evandrosouza-developer/Tester-ps2-msx/Documentation/Tester Technical and Performance Manual.pdf

# Technical and Performance Manual

### Tester for PS/2 to MSX Keyboard adapter

## Introduction

This document aims to report applicable tests capability of the equipment developed to simulate the MSX keyboard subsystem.

## Technical foundation

### How MSX reads the keyboard

The MSX standard says that to read a key from the keyboard, you have to choose a column (Y_SCAN) through PC3:0 [IO port 0xAA – The BCD decoder (CI-16 7445 in HB-8000 and the equivalent chip inside the keyboard on XP-800) will put a low level onto the selected Y line] and read 8 bits of the other side of the matrix through PB7:0 without any extra delays. Here is two MSX example schematics to illustrate how to:

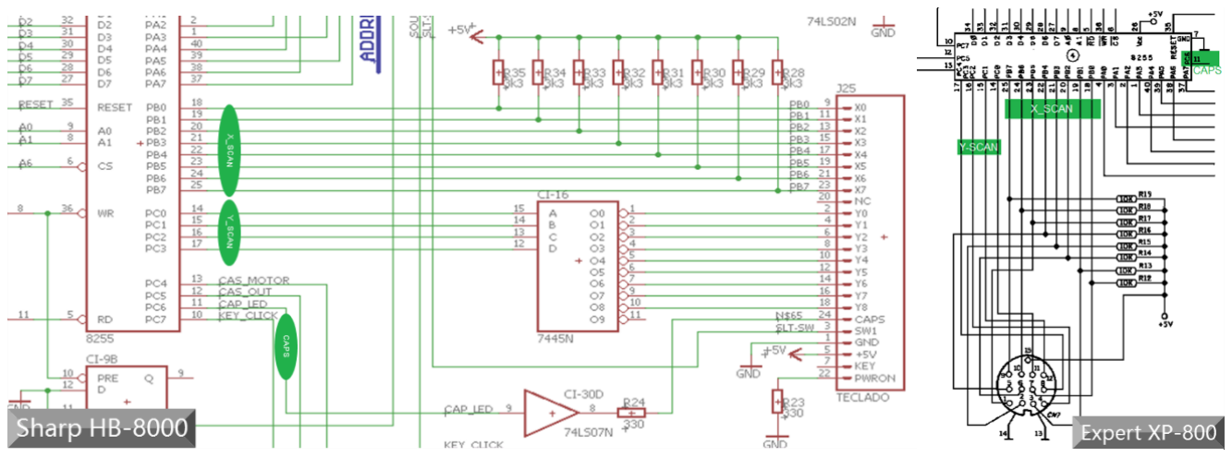
[picture p1: figure]

The detailed Z80 timing of a real MSX is represented here:

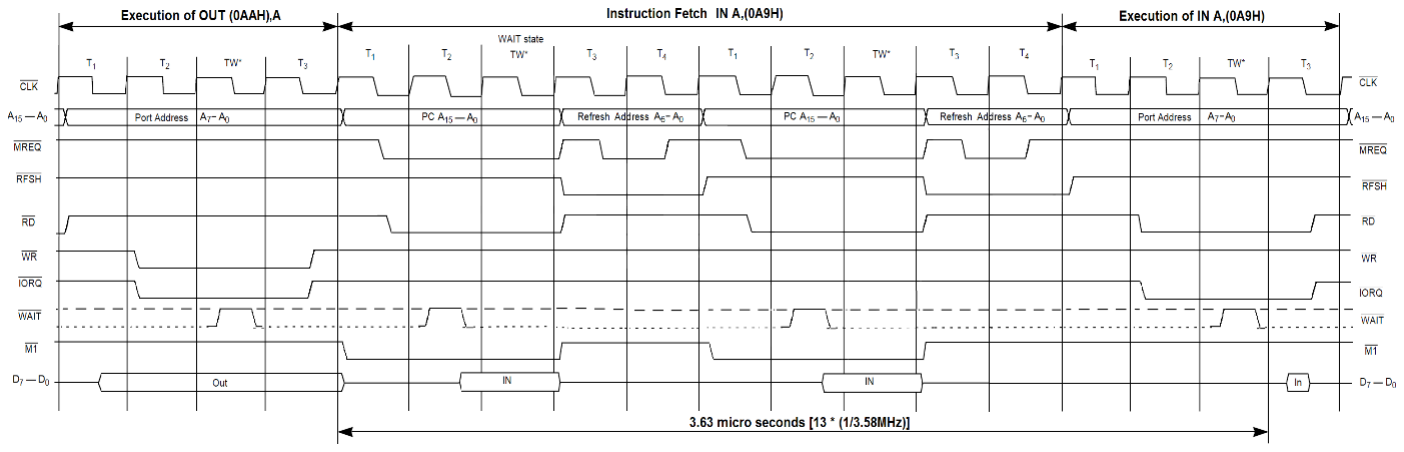
[picture p2: figure]

We have a window of about 3.65µs between the data is available from OUT (0xAA), A until the data sampling of the IN A, (0xA9) command.

So, to make a useful develop tool MSX keyboard subsystem simulator, I need to add the following configurable parameters:

1) Scan frequency: Number of “out’s” per second;
2) Delay to read the window time between the out and the sampled data (our 3.63µs);
3) Control the start and end colunms of the sweep;
4) Pause, single sweep and step-by-step run;
5) Control of the state of Caps Lock and Kana Lock: Blink, on and off states independently configurable.

The terminal configuration screen is:

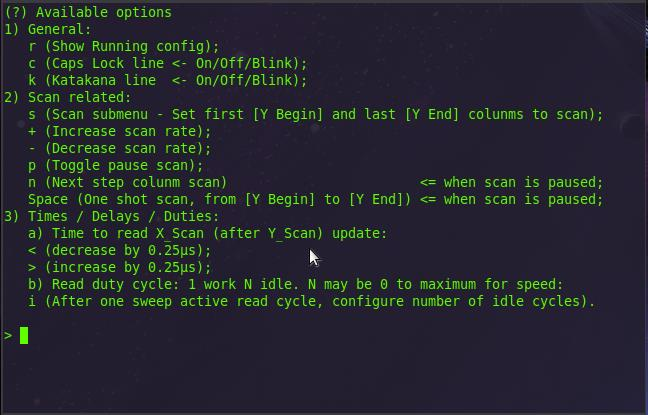
[picture p3: figure]

Timing definitions and controls used in this design:

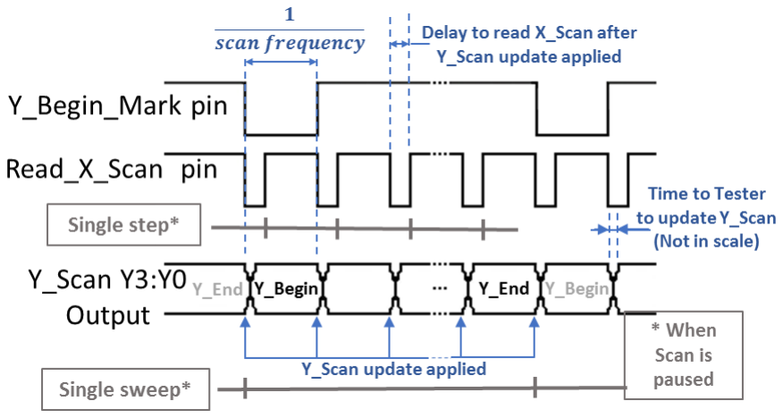
[picture p4: figure]

## The electronics

The electronics is quite simple => Only need a low cost Blue Pill (STM32F103C6T6 or greater) or Black Pill (STM32F401CCU6 or greater), with no PCB at all:

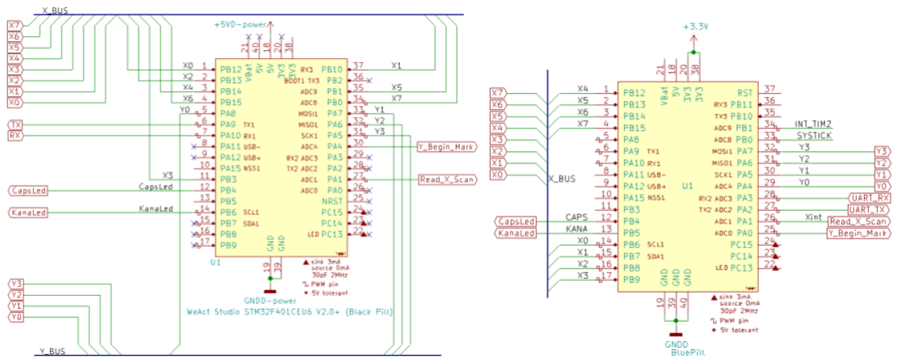
[picture p5: figure]

The choice of this was based on the pre-requisites:

1) Easy to get (High availability and low cost);
2) Use of the same platform of STM32F1 and STM32F4 based PS/2 to MSX Keyboard adapter (Hardware and Software develop tools), to minimize time to go, as learning time is mitigated;
3) Capability to use the same basic Firmware Structure: only develop complementary functions;

Real examples of working.

## 1) MSX Gradiente Expert XP-800 application:

Column scan frequency: 120KHz;

Y_Begin: 0;

Y_End: 9

Here is the keyboard map:

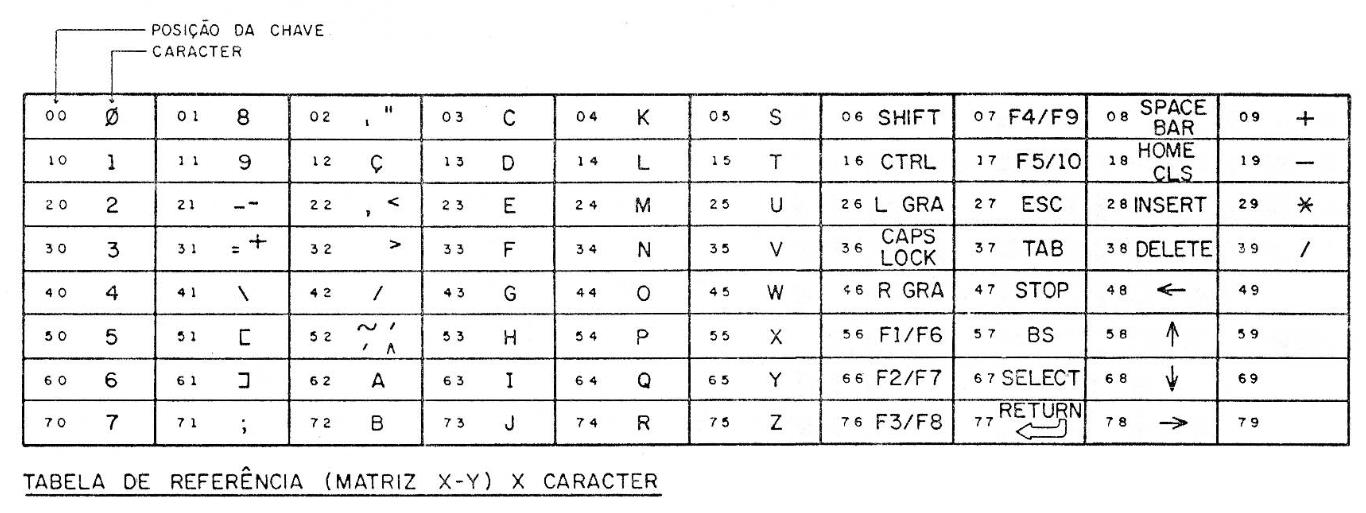
[picture p6: figure]

The yellow line (channel 1) marks Y_Begin (freq=120K/10 [0 to 9]) and blue line marks each column (120KHz). The start of data begins at falling transition (valid on both situations):

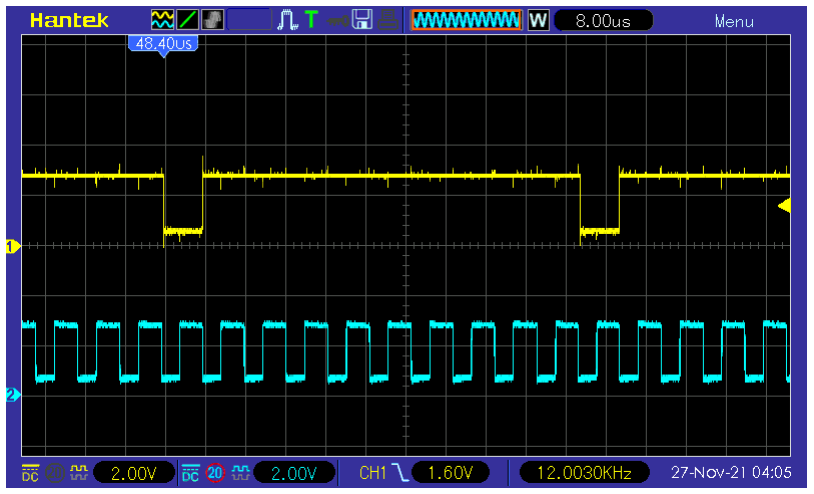
[picture p7: figure]

2) Sharp/Epcom Hotbit HB-8000 application:

Column scan frequency: 120KHz;

Y_Begin: 0;

Y_End: 8

The keyboard map – Here the yellow mapping are the keys who shift function differs from PS/2:

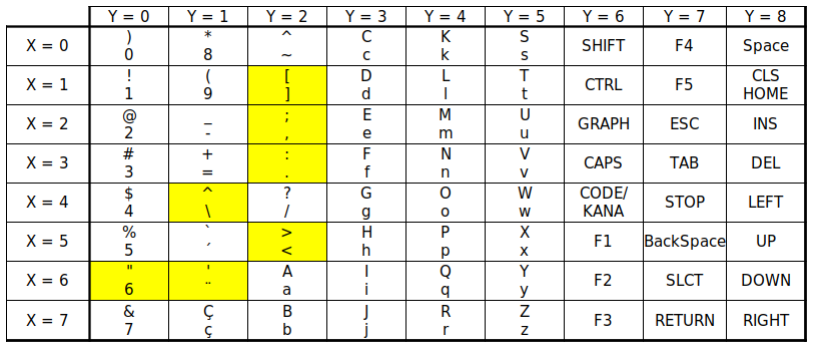
[picture p8: figure]

Now the yellow line shows 13.33KHz, because we are scanning 9 columns [0 to 8], instead of 10 [0 to 9] as used in XP-800:

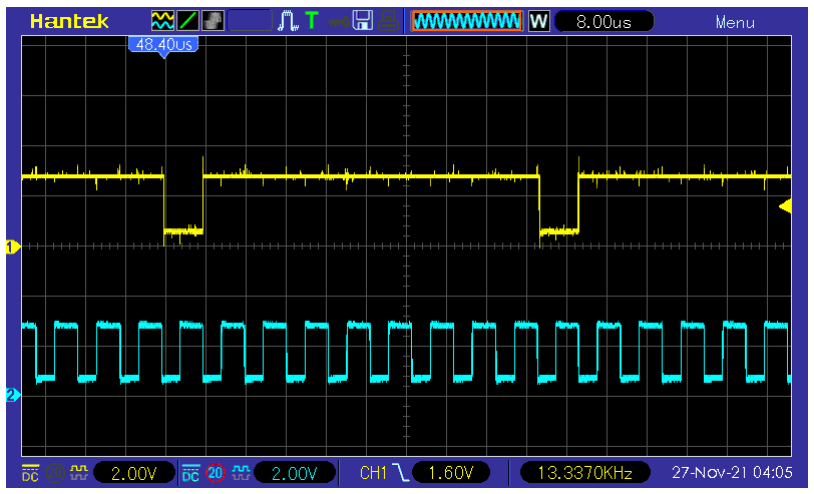
[picture p9: figure]

Here are the benchmarks of setting reading window.

IMPORTANT: Scan frequency and delay to read timing are referred to each colunm, not the all the keyboard.

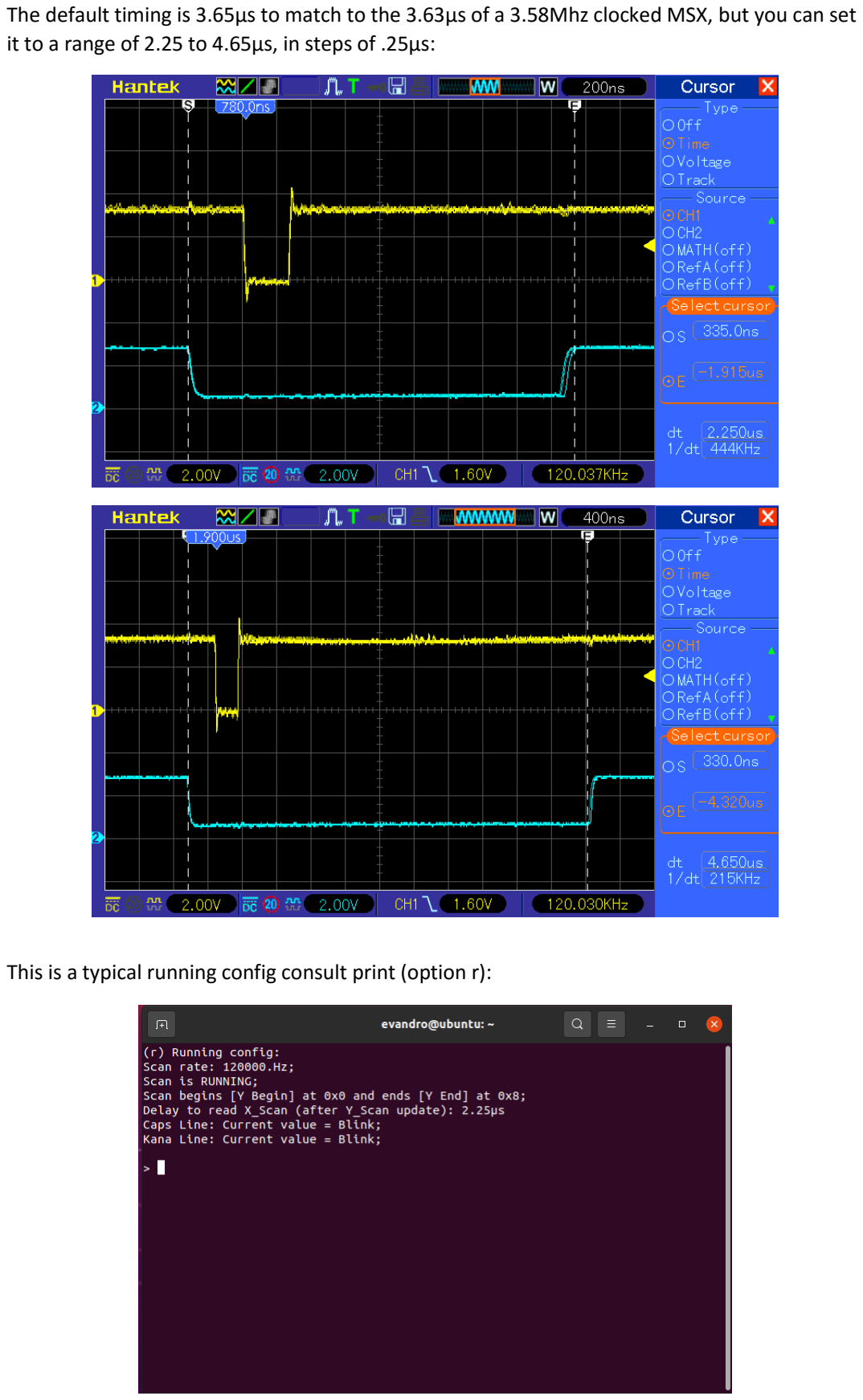
[picture p10: page 6]

The default timing is 3.65µs to match to the 3.63µs of a 3.58Mhz clocked MSX, but you can set it to a range of 2.25 to 4.65µs, in steps of .25µs:

This is a typical running config consult print (option r):

## How to use this tool to measure the performance of the PS/2 to MSX Keyboard adapter:

1) To measure the delay to the Adapter answer the request, here an example:

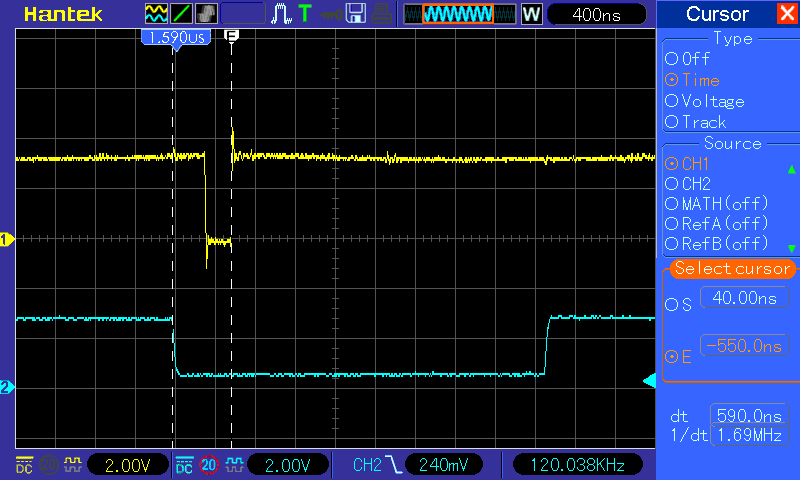
[picture p11: figure]

In this example, we can see the total performance of a response from the point the Tester put data (Pin S, at port A1 of Tester) to the point the routine ended processing (Pin E, on the PS2-MSXF4 Adapter’s port B7).

Other data could be how much time it spends “on processing”:

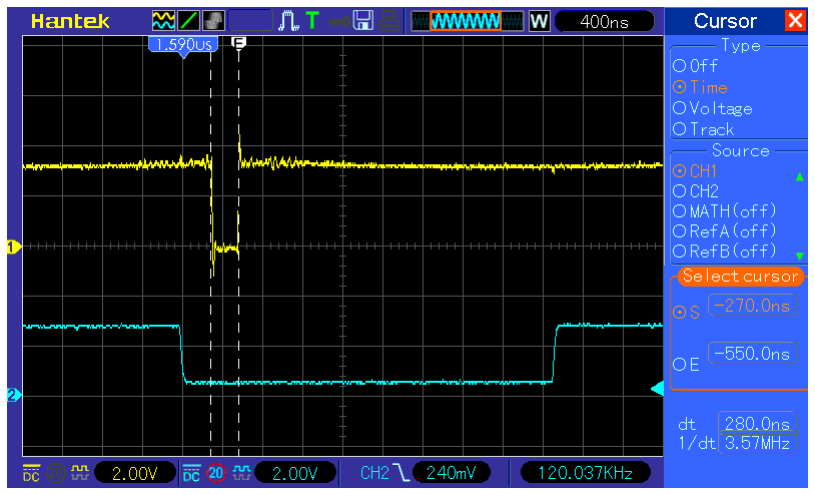
[picture p12: figure]

To get referenced, the blue trace window is a 3.65µs wide:

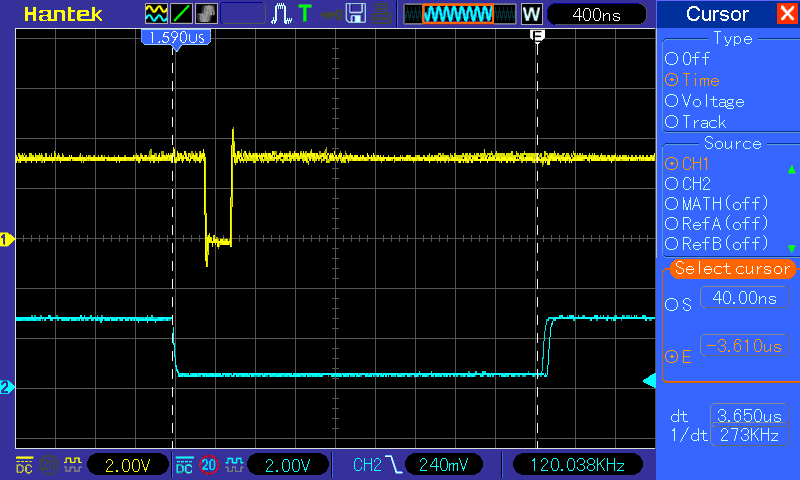
[picture p13: figure]
