evandrosouza-developer/Tester-ps2-msx/Documentation/tester-ps2-msxF1 Schematics.pdf

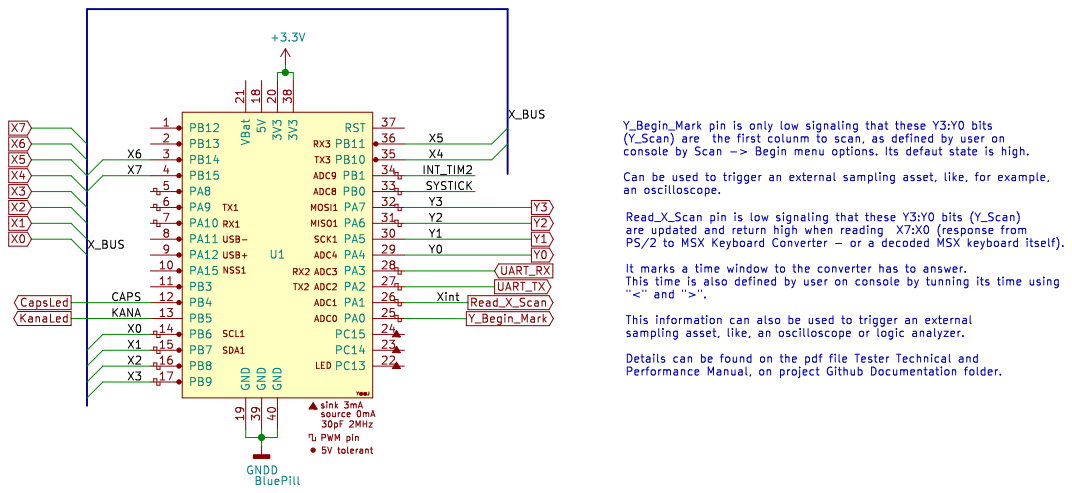
[picture p20: page 1]
