evandrosouza-developer/Tester-ps2-msx/Documentation/tester-ps2-msxF4 Schematics.pdf

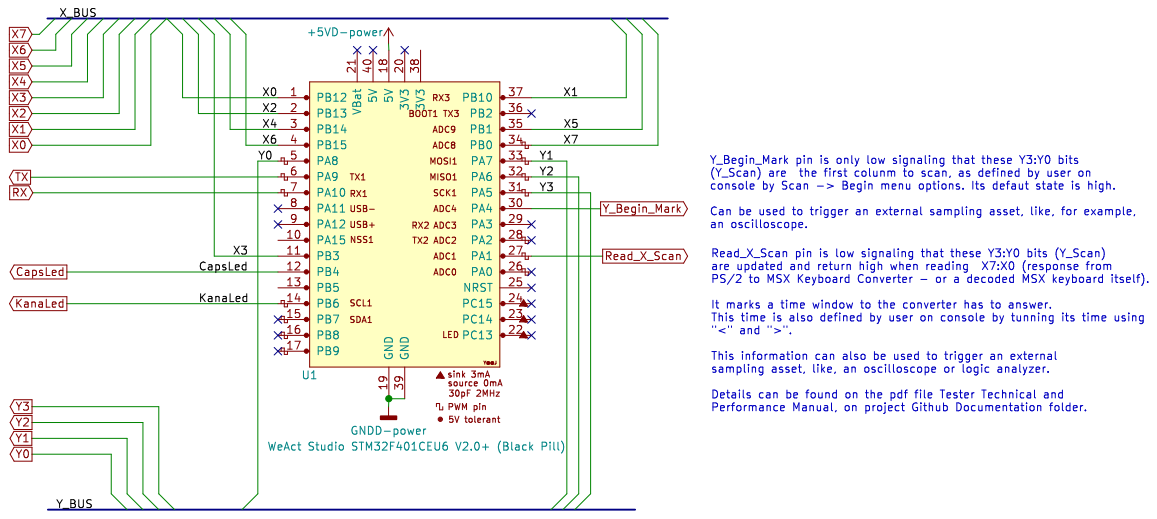
[picture p21: page 1]
