evandrosouza-developer/Tester-ps2-msx/Documentation/Kicad/F1/Tester F1 Schematic.pdf

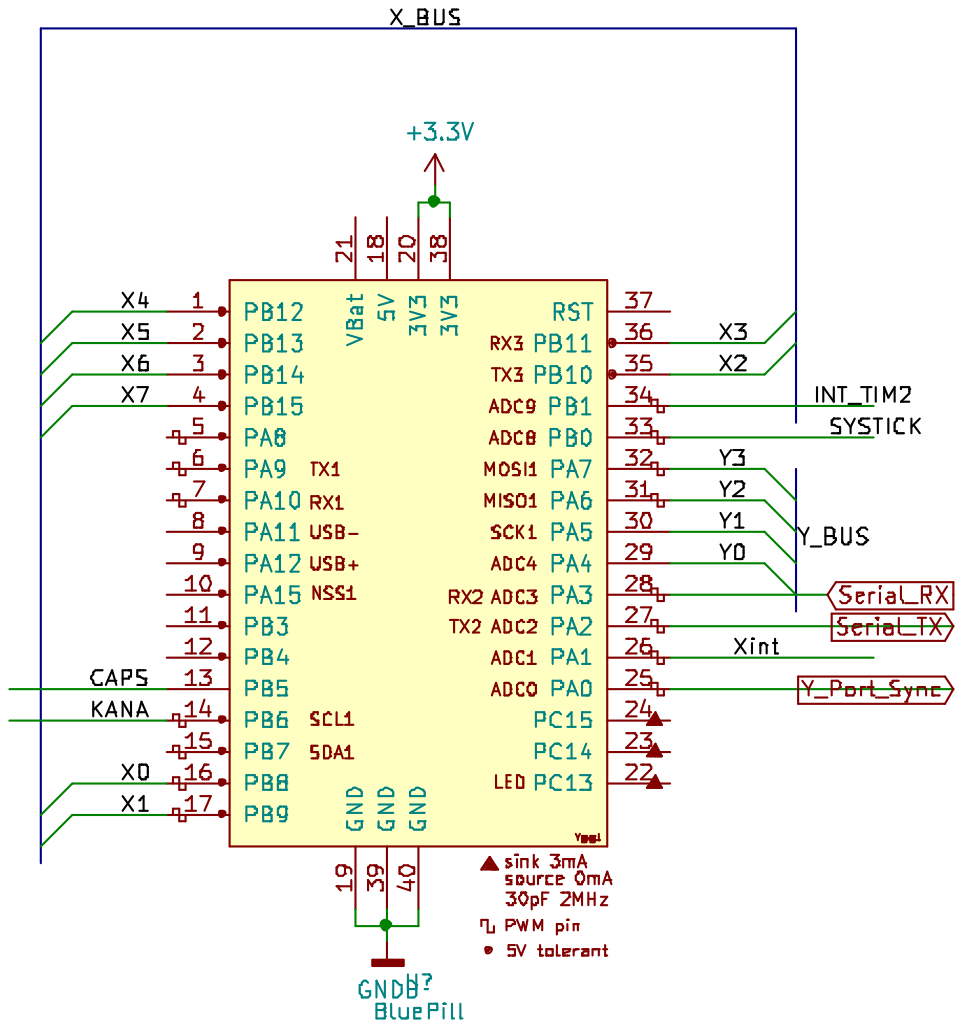
[picture p22: page 1]
