evandrosouza-developer/Tester-ps2-msx/t_msxmap.cpp

/** @addtogroup 07 msxmap t_msxmap_misc_group
 *
 * @ingroup infrastructure_apis
 *
 * @file t_msxmap.cpp General port initializations, complementary string function and mounts data of MSX adapter changes
 *
 * @brief <b>General port initializations, complementary string function and mounts data of MSX adapter changes</b>
 *
 * @version 1.0.0
 *
 * @author @htmlonly &copy; @endhtmlonly 2022
 * Evandro Souza <evandro.r.souza@gmail.com>
 *
 * @date 01 September 2022
 *
 * This library supports the setup pin ports and process the read data from 
 * PS/2 to MSX Keyboard Converter to be presented at the main menu loop,
 * to both the STM32F4 and STM32F1 series of ARM Cortex Microcontrollers
 * by ST Microelectronics.
 *
 * LGPL License Terms ref lgpl_license
 */
/*
 * This file is part of the MSX Keyboard Subsystem Emulator project.
 *
 * Copyright (C) 2022 Evandro Souza <evandro.r.souza@gmail.com>
 *
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
 * You should have received a copy of the GNU Lesser General Public License
 * along with this library.  If not, see <http://www.gnu.org/licenses/>.
 */

//Use Tab width=2

#include <libopencm3/cm3/systick.h>
#include <libopencm3/stm32/rcc.h>

#include "t_msxmap.h"

//Variáveis globais: Visíveis por todo o contexto do programa
extern uint32_t systicks;                           //Declared on sys_timer.cpp
extern uint8_t scancount_init, scancount_end;       //Declared on sys_timer.cpp
extern uint8_t y_scan;                              //Declared on sys_timer.cpp
extern bool wait_flag, single_step, single_sweep;   //Declared on sys_timer.cpp
extern uint8_t inactivity_cycles[SCAN_POINTER_SIZE];//Declared on sys_timer.cpp
extern volatile uint64_t TIM2_Update_Cnt;           //Declarated on hr_timer.c
extern volatile uint64_t u64_TIM2_Cnt;              //Declarated on hr_timer.c
extern uint16_t init_inactivity_cycles[SCAN_POINTER_SIZE];//Declared on tester-ps2-msx.cpp
extern uint32_t scan_pointer;                       //Declared on tester-ps2-msx.cpp
uint8_t msx_X;

volatile uint32_t previous_y_systick[ 16 ] = {0, 0, 0, 0, 0, 0, 0, 0, 0, 0, 0, 0, 0, 0, 0, 0 };

//MSX Keyboard - Used to signalize status change in MSX matrix
uint8_t msx_X_prev[ 16 ] =  {0xFF, 0xFF, 0xFF, 0xFF, 0xFF, 0xFF, 0xFF, 0xFF, 
                             0xFF, 0xFF, 0xFF, 0xFF, 0xFF, 0xFF, 0xFF, 0xFF}; //The index is used to store Y

uint8_t mountISRstr[MNTSTR_SIZE];
struct s_pascal_string pascal_string;


/**
 * @brief Properly sets up the all pins that interfaces to PS/2 to MSX Keyboard Converter.
 * 
 */
void msxmap::msx_interface_setup(void)
{
#if MCU == STM32F103
  //Not the STM32 default: Pull up;
  gpio_set(X7_port,
  X7_pin_id | X6_pin_id | X5_pin_id | X4_pin_id | X3_pin_id | X2_pin_id | X1_pin_id | X0_pin_id);

  //Init input port B15:8
  gpio_set_mode(X7_port, GPIO_MODE_INPUT, GPIO_CNF_INPUT_PULL_UPDOWN, 
  X7_pin_id | X6_pin_id | X5_pin_id | X4_pin_id | X3_pin_id | X2_pin_id | X1_pin_id | X0_pin_id);

  // GPIO pins for MSX keyboard Y scan (PC3:0 of the MSX 8255 - PC3 MSX 8255 Pin 17)
  gpio_set(Y3_port, Y3_pin_id); //pull up resistor
  gpio_set_mode(Y3_port, GPIO_MODE_OUTPUT_50_MHZ, GPIO_CNF_OUTPUT_PUSHPULL, Y3_pin_id); // PC3 (MSX 8255 Pin 17)
  gpio_port_config_lock(Y3_port, Y3_pin_id);

  // GPIO pins for MSX keyboard Y scan (PC3:0 of the MSX 8255 - PC2 MSX 8255 Pin 16)
  gpio_set(Y2_port, Y2_pin_id); //pull up resistor
  gpio_set_mode(Y2_port, GPIO_MODE_OUTPUT_50_MHZ, GPIO_CNF_OUTPUT_PUSHPULL, Y2_pin_id); // PC2 (MSX 8255 Pin 16)
  gpio_port_config_lock(Y2_port, Y2_pin_id);

  // GPIO pins for MSX keyboard Y scan (PC3:0 of the MSX 8255 - PC1 MSX 8255 Pin 15)
  gpio_set(Y1_port, Y1_pin_id); //pull up resistor
  gpio_set_mode(Y1_port, GPIO_MODE_OUTPUT_50_MHZ, GPIO_CNF_OUTPUT_PUSHPULL, Y1_pin_id); // PC1 (MSX 8255 Pin 15)
  gpio_port_config_lock(Y1_port, Y1_pin_id);

  // GPIO pins for MSX keyboard Y scan (PC3:0 of the MSX 8255 - PC0 MSX 8255 Pin 14)
  gpio_set(Y0_port, Y0_pin_id); //pull up resistor
  gpio_set_mode(Y0_port, GPIO_MODE_OUTPUT_50_MHZ, GPIO_CNF_OUTPUT_PUSHPULL, Y0_pin_id); // PC0 (MSX 8255 Pin 14)
  gpio_port_config_lock(Y0_port, Y0_pin_id);

  // GPIO pin for Oscilloscope sync
  gpio_set(Y_Begin_Mark_port, Y_Begin_Mark_pin); //pull up resistor
  gpio_set_mode(Y_Begin_Mark_port, GPIO_MODE_OUTPUT_50_MHZ, GPIO_CNF_OUTPUT_PUSHPULL, Y_Begin_Mark_pin); // PC0 (MSX 8255 Pin 14)
  gpio_port_config_lock(Y_Begin_Mark_port, Y_Begin_Mark_pin);

  // GPIO pins for CAPS & KANA
  gpio_set(CAPS_port, CAPS_pin_id); //pull up resistor
  gpio_set_mode(CAPS_port, GPIO_MODE_OUTPUT_50_MHZ, GPIO_CNF_OUTPUT_OPENDRAIN, CAPS_pin_id);
  gpio_port_config_lock(CAPS_port, CAPS_pin_id);

  gpio_set_mode(KANA_port, GPIO_MODE_OUTPUT_50_MHZ, GPIO_CNF_OUTPUT_OPENDRAIN, KANA_pin_id);
  gpio_port_config_lock(KANA_port, KANA_pin_id);
#endif  //#if MCU == STM32F103

#if MCU == STM32F401
  //Not the STM32 default: Pull up;
  //Init input port B15:8
  gpio_mode_setup (X7_port, GPIO_MODE_INPUT, GPIO_PUPD_PULLUP, 
  X7_pin_id | X6_pin_id | X5_pin_id | X4_pin_id | X3_pin_id | X2_pin_id | X1_pin_id | X0_pin_id);   


  // GPIO pins for MSX keyboard Y scan (PC3:0 of the MSX 8255 - PC3 MSX 8255 Pin 17)
  gpio_mode_setup (Y3_port, GPIO_MODE_OUTPUT, GPIO_PUPD_PULLUP, Y3_pin_id);
  gpio_set_output_options (Y3_port, GPIO_OTYPE_PP, GPIO_OSPEED_50MHZ, Y3_pin_id);
  gpio_port_config_lock(Y3_port, Y3_pin_id);

  // GPIO pins for MSX keyboard Y scan (PC3:0 of the MSX 8255 - PC2 MSX 8255 Pin 16)
  gpio_mode_setup (Y2_port, GPIO_MODE_OUTPUT, GPIO_PUPD_PULLUP, Y_Begin_Mark_pin);
  gpio_set_output_options (Y2_port, GPIO_OTYPE_PP, GPIO_OSPEED_50MHZ, Y_Begin_Mark_pin);
  gpio_port_config_lock(Y2_port, Y_Begin_Mark_pin);

  // GPIO pins for MSX keyboard Y scan (PC3:0 of the MSX 8255 - PC1 MSX 8255 Pin 15)
  gpio_mode_setup (Y2_port, GPIO_MODE_OUTPUT, GPIO_PUPD_PULLUP, Y_Begin_Mark_pin);
  gpio_set_output_options (Y2_port, GPIO_OTYPE_PP, GPIO_OSPEED_50MHZ, Y_Begin_Mark_pin);
  gpio_port_config_lock(Y1_port, Y1_pin_id);

  // GPIO pins for MSX keyboard Y scan (PC3:0 of the MSX 8255 - PC0 MSX 8255 Pin 14)
  gpio_mode_setup (Y0_port, GPIO_MODE_OUTPUT, GPIO_PUPD_PULLUP, Y0_pin_id);
  gpio_set_output_options (Y0_port, GPIO_OTYPE_PP, GPIO_OSPEED_50MHZ, Y_Begin_Mark_pin);
  gpio_port_config_lock(Y0_port, Y0_pin_id);

  // GPIO pin for Oscilloscope sync
  gpio_mode_setup (Y_Begin_Mark_port, GPIO_MODE_OUTPUT, GPIO_PUPD_PULLUP, Y_Begin_Mark_pin); // PC0 (MSX 8255 Pin 14)
  gpio_set_output_options (Y_Begin_Mark_port, GPIO_OTYPE_PP, GPIO_OSPEED_50MHZ, Y_Begin_Mark_pin);
  gpio_port_config_lock(Y_Begin_Mark_port, Y_Begin_Mark_pin);

  // GPIO pins for CAPS & KANA
  gpio_mode_setup (CAPS_port, GPIO_MODE_OUTPUT, GPIO_PUPD_PULLUP, CAPS_pin_id);
  gpio_set_output_options (CAPS_port, GPIO_OTYPE_OD, GPIO_OSPEED_50MHZ, Y_Begin_Mark_pin);
  gpio_port_config_lock(CAPS_port, CAPS_pin_id);

  gpio_mode_setup (KANA_port, GPIO_MODE_OUTPUT, GPIO_PUPD_PULLUP, KANA_pin_id);
  gpio_set_output_options (KANA_port, GPIO_OTYPE_OD, GPIO_OSPEED_50MHZ, KANA_pin_id);
  gpio_port_config_lock(KANA_port, KANA_pin_id);
#endif  //#if MCU == STM32F401

  // Initialize ring buffer for readings of DUT inside isr.
  pascal_string_init(&pascal_string, mountISRstr, MNTSTR_SIZE);

  //Init init_inactivity_cycles[SCAN_POINTER_SIZE]
  for(uint16_t i = 0; i < SCAN_POINTER_SIZE; i++)
	{
    #if defined CHECK_INDEX
    check_idx_u16(i, (uintptr_t)init_inactivity_cycles, sizeof(init_inactivity_cycles));
    #endif
		init_inactivity_cycles[i] = 0;  //working values
    #if defined CHECK_INDEX
    check_idx_u16(i, (uintptr_t)inactivity_cycles, sizeof(inactivity_cycles));
    #endif
		inactivity_cycles[i] = 0;       //working values
	}
}


/**
 * @brief Properly sets up the all debug output pins.
 *
 */
void msxmap::general_debug_setup(void)
{
#if MCU == STM32F103
  // GPIO C13 is the onboard LED
  gpio_set_mode(EMBEDDED_LED_port, GPIO_MODE_OUTPUT_2_MHZ, GPIO_CNF_OUTPUT_OPENDRAIN, EMBEDDED_LED_pin);
  // Enable the led. It is active LOW, but the instruction was omitted, since 0 is the default.

  // GPIOB5 is a 3.3V pin. I can not use it with real MSX. In aim to reduce wasted power, let avoid let it floating,
  // so lets fix a state: Set it to 1 (set bit).
  gpio_set_mode(GPIOB, GPIO_MODE_INPUT, GPIO_CNF_INPUT_PULL_UPDOWN, GPIO5);
  gpio_set(GPIOB, GPIO5); //pull up (internal) resistor

  gpio_set_mode(SYSTICK_port, GPIO_MODE_OUTPUT_50_MHZ, GPIO_CNF_OUTPUT_PUSHPULL, SYSTICK_pin_id);
  gpio_set(SYSTICK_port, SYSTICK_pin_id); //Default condition is "1"

  gpio_set_mode(Read_X_Scan_port, GPIO_MODE_OUTPUT_50_MHZ, GPIO_CNF_OUTPUT_PUSHPULL, Read_X_Scan_pin_id); // PC2 e 3 (MSX 8255 Pin 17)
  gpio_set(Read_X_Scan_port, Read_X_Scan_pin_id); //Default condition is "1"
  
  gpio_set_mode(INT_TIM2_port, GPIO_MODE_OUTPUT_50_MHZ, GPIO_CNF_OUTPUT_PUSHPULL, TIM2UIF_pin_id); // PC2 e 3 (MSX 8255 Pin 17)
  gpio_set(INT_TIM2_port, TIM2UIF_pin_id); //Default condition is "1"
#endif  //#if MCU == STM32F103

#if MCU == STM32F401
  // GPIO C13 is the onboard LED
  gpio_mode_setup (EMBEDDED_LED_port, GPIO_MODE_OUTPUT, GPIO_PUPD_PULLUP, EMBEDDED_LED_pin);
  gpio_set_output_options (EMBEDDED_LED_port, GPIO_OTYPE_OD, GPIO_OSPEED_2MHZ, EMBEDDED_LED_pin);
  // Enable the led. It is active LOW, but the instruction was omitted, since 0 is the default.

  gpio_set(SYSTICK_port, SYSTICK_pin_id); //Default condition is "1"
  gpio_mode_setup (SYSTICK_port, GPIO_MODE_INPUT, GPIO_PUPD_PULLUP, SYSTICK_pin_id);
  gpio_set_output_options (SYSTICK_port, GPIO_OTYPE_OD, GPIO_OSPEED_2MHZ, SYSTICK_pin_id);

  gpio_set(Read_X_Scan_port, Read_X_Scan_pin_id); //Default condition is "1"
  gpio_mode_setup (Read_X_Scan_port, GPIO_MODE_OUTPUT, GPIO_PUPD_PULLUP, Read_X_Scan_pin_id);
  gpio_set_output_options (Read_X_Scan_port, GPIO_OTYPE_OD, GPIO_OSPEED_2MHZ, Read_X_Scan_pin_id);
  
  gpio_set(INT_TIM2_port, TIM2UIF_pin_id); //Default condition is "1"
  gpio_mode_setup (INT_TIM2_port, GPIO_MODE_OUTPUT, GPIO_PUPD_PULLUP, TIM2UIF_pin_id);              // PC2 e 3 (MSX 8255 Pin 17)
  gpio_set_output_options (INT_TIM2_port, GPIO_OTYPE_PP, GPIO_OSPEED_50MHZ, Read_X_Scan_pin_id);
#endif  //#if MCU == STM32F401
}


//This routine will be called from delay_usec (from t_sys_timer / t_hr_timer)
void portXread(void)
{
  uint8_t mountstring[6];         //Used in usart_send_string()

  //To be measured the real time from column *Y_ writing to reading, by putting an oscilloscope at pin A1
  GPIO_BSRR(Read_X_Scan_port) = Read_X_Scan_pin_id; //Back to default condition ("1")

  // Read the MSX keyboard X answer through GPIO pins X7:X0
#if MCU == STM32F103
  uint16_t tmp;
  //tmp = (gpio_port_read(X0_port) >> 6); //Read bits B15, B14, B11, B10, B9, B8, B7 and B6 (1100.1111.1100.0000 CFC0)
  tmp = (gpio_port_read(X0_port) & 0xCFC0); //Read bits B15, B14, B11, B10, B9, B8, B7 and B6 (1100.1111.1100.0000 CFC0)
  tmp = tmp >> 6;
  msx_X = (uint8_t)((tmp & 0x300) >> 2) | (uint8_t)(tmp & 0x3F);
#endif  //#if MCU == STM32F103
#if MCU == STM32F401
  uint16_t tmp = (gpio_port_read(X0_port));
  //Bits order on F4 are different!
  //Calculate them are easer (and smaller) than find values in a 16 bits lookup table!
  //Bit 7
  msx_X =  (tmp & (1 << MSX_X_BIT7)) ? 1 << 7 : 0;
  //Bit 6
  msx_X |= (tmp & (1 << MSX_X_BIT6)) ? 1 << 6 : 0;
  //Bit 5
  msx_X |= (tmp & (1 << MSX_X_BIT5)) ? 1 << 5 : 0;
  //Bit 4
  msx_X |= (tmp & (1 << MSX_X_BIT4)) ? 1 << 4 : 0;
  //Bit 3
  msx_X |= (tmp & (1 << MSX_X_BIT3)) ? 1 << 3 : 0;
  //Bit 2
  msx_X |= (tmp & (1 << MSX_X_BIT2)) ? 1 << 2 : 0;
  //Bit 1
  msx_X |= (tmp & (1 << MSX_X_BIT1)) ? 1 << 1 : 0;
  //Bit 0
  msx_X |= (tmp & (1 << MSX_X_BIT0)) ? 1 << 0 : 0;
#endif  //#if MCU == STM32F401
  
  if (msx_X != msx_X_prev[y_scan])  //Print info if ps2-MSX adapter has updated data of this y_scan
  {
    //Store the new value of msx_X to allow print the future keyboard changes
    #if defined CHECK_INDEX
    check_idx_u16(y_scan, (uintptr_t)msx_X_prev, sizeof(msx_X_prev));
    #endif
    msx_X_prev[y_scan] = msx_X;
    //Read the result of this reading and mount it to a circular buffer string
    //Print the changes through filling buffer that will be transfered via console in main
    //Print y_scan and msx_X
    string_append((uint8_t*)"Y", &pascal_string);
    conv_uint8_to_2a_hex(y_scan, mountstring);
    string_append(&mountstring[1], &pascal_string);
    string_append((uint8_t*)" X", &pascal_string);
    conv_uint8_to_2a_hex(msx_X, mountstring);
    string_append((uint8_t*)mountstring, &pascal_string);
    string_append((uint8_t*)"\r\n> ", &pascal_string);
  }
  if (!wait_flag)
  {//Update here to next valid scan
    y_scan++;
    if (y_scan > scancount_end)
    {
      y_scan = scancount_init;
      #if defined CHECK_INDEX
      check_idx_u16(scan_pointer, (uintptr_t)inactivity_cycles, sizeof(inactivity_cycles));
      #endif
      inactivity_cycles[scan_pointer] = init_inactivity_cycles[scan_pointer];
      if(single_sweep)
      {//Last colunm to scan: Back to paused state
        single_sweep = false;
        wait_flag = true;   //Do this last one and, after portXread executed, stop single_sweep
      } //if(single_sweep)
    }
  }
  if (single_step)
  {//Already run once, so returns to paused state
    single_step = false;
    wait_flag = true;
  }
}
