evandrosouza-developer/Tester-ps2-msx/cdcacm.h

/** @defgroup 06 USB USB_Group
 *
 * @ingroup infrastructure_apis
 *
 * @file cdcacm.h USB Support routines group on STM32F4 and STM32F1.
 *
 * @brief <b>USB Support routines group on STM32F4 and STM32F1. Header file of cdcacm.c.</b>
 *
 * @version 1.0.0
 *
 * @author @htmlonly &copy; @endhtmlonly 2022
 * Evandro Souza <evandro.r.souza@gmail.com>
 * @author @htmlonly &copy; @endhtmlonly 2010
 * Gareth McMullin <gareth@blacksphere.co.nz>
 *
 * @date 01 September 2022
 *
 * This library supports the USART with DMA in the STM32F4 and STM32F1
 * series of ARM Cortex Microcontrollers by ST Microelectronics.
 *
 * LGPL License Terms ref lgpl_license
 */

/*
 * This file is part of the PS/2 to MSX keyboard Converter and 
 * MSX Keyboard Subsystem Emulator projects, based on libopencm3 project.
 *
 * Copyright (C) 2022 Evandro Souza <evandro.r.souza@gmail.com>
 *
 * Based on CDCACM example of:
 * Copyright (C) 2010 Gareth McMullin <gareth@blacksphere.co.nz>
 *
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
 * You should have received a copy of the GNU Lesser General Public License
 * along with this library.  If not, see <http://www.gnu.org/licenses/>.
 */



#if !defined CDCACM_H
#define CDCACM_H

#ifdef __cplusplus
extern "C" {
#endif

#include <stdlib.h>
#include <libopencm3/stm32/rcc.h>
#include <libopencm3/cm3/nvic.h>
#include <libopencm3/stm32/gpio.h>
#include <libopencm3/usb/usbd.h>
#include <libopencm3/cm3/scb.h>

#include "system.h"
#include "serial.h"
#include "hr_timer.h"
#include "serial_no.h"


/**
 * @brief Defines line_coding structure.
 * 
 */
static const struct usb_cdc_line_coding line_coding = {
  .dwDTERate = 115200,
  .bCharFormat = USB_CDC_1_STOP_BITS,
  .bParityType = USB_CDC_NO_PARITY,
  .bDataBits = 8
};


/**
 * @brief Inits the cdcacm sub system.
 * 
 */
void cdcacm_init(void);


/**
 * @brief Sets the specified endpoint to Not Acknowledge, to disables communication.
 *
 * @param ep endpoint with direction bit.
 */
void set_nak_endpoint(uint8_t ep);


/**
 * @brief Clears the specified endpoint Not Acknowledg, to allow communication.
 *
 * @param ep endpoint with direction bit.
 */
void clear_nak_endpoint(uint8_t ep);


/**
 * @brief Starts a communication pipe with an IN Endpoint, to allow that the USB callbacks can take control of the pipe.
 *
 * @param ring pointer to struct sring.
 * @param ep endpoint with direction bit.
 */
void first_put_ring_content_onto_ep(struct sring* ring, uint8_t ep);


/**
 * @brief Returns current usb configuration, or 0 if not configured.
 *
 * @returns Returns current usb configuration, or 0 if not configured.
 */
int cdcacm_get_config(void);


/**
 * @brief Disables the USB to make host disconnect.
 * 
 */
void disable_usb(void);



#ifdef __cplusplus
}
#endif

#endif  //#if !defined CDCACM_H
