evandrosouza-developer/Tester-ps2-msx/(commit log)

2021-11-19 Tester for matrix keyboard
    This code was made to facilitates a STM32 chip to act as a MSX keyboard sub system emulator, to test the PS/2 keyboard to MSX adapter.
    This code is common to the two adapters I made, both based in STM32 (3.3V). It is configurable through serial console.
2021-11-19 Schematics of the project
    Kicad schematics of the design. It is not planned to do a PCB for this one, as I'm using a blue pill as the hardware.
    [MSX_tester.kicad_pcb, MSX_tester.sch]
2021-11-21 Fix presented couint
    Fixes on the presentation of Yx value due to wrong position of y_count update.
    [t_msxmap.cpp]
2021-11-23 Fully functional.
    Fixes presenting X count, by moving some pieces of code. This is a fully functional desired target.
    [t_msxmap.cpp]
2021-12-04 Tester for PS/2 to MSX Adapter is fully functional
    Add the Technical Manual. It describes a how-to tests. It is a on going material.
2022-08-14 Update to add USB device and serial performance
    After a long time without news, I have implemented new performance resources in serial communication, using DMA in both TX and RX, but the most work was done to be allowed to connect the control console through USB (to remmember: the original implementation the console was through serial), and so, eliminate the need of USB<=>Serial converter in most new computers or, even the level adapter (RS-232/V.24 voltages from/to 3.3V) if using an available PC RS-232 port.
    The freeed serial port now is used as a Serial<=>USB converter.
2022-08-14 Add USB device and better serial performance
    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
2022-08-14 Delete stm32f103x8msx.ld
    No more needed.
2022-08-15 Update README.md
    Added USB conectivity to connect to console and one USB<=>Serial converter. See on the two pdf files more technical details. This equipment is complement of PS/2 to MSX key board adapter, so more technical details can be found on that pages.
2022-08-15 Add files via upload
    Added USB conectivity to connect to console and one USB<=>Serial converter. This update was to document the ability to change serial communication paramenters through host. This equipment is complement of PS/2 to MSX key board adapter, so more technical details can be found on that pages. See on the two pdf files more technical details about the design and application.
2022-09-11 Update to implement new features and F4 support
    Emulator of MSX Keyboard subsystem, to make tests and performance measurements os the PS/2 to MSX Adatpters. Now implemented the console as a USB device, plus a USB<=>Serial converter
2022-09-11 Updated to implement new features and F4 support
    Emulator of MSX Keyboard subsystem, to develop, make tests and performance measurements os the PS/2 to MSX Adatpters. Now implemented the console as a USB device, plus a USB<=>Serial converter.
2022-09-13 Update to implement new features and F4 support
    Doxygen ready. Emulator of MSX Keyboard subsystem, to make tests and performance measurements of the PS/2 to MSX Adatpter. Now implemented the Core M4 suppport.
    If USB is enumerated, console is attached to USB device, plus the USART is done as a USB<=>Serial converter.
2022-09-15 Update to implement new features and F4 support
    Doxygen at working phase. Emulator of MSX Keyboard subsystem, to make tests and performance measurements of the PS/2 to MSX Adatpter. Now implemented the Core M4 suppport.
    If USB is enumerated, console is attached to USB device, plus the USART is done as a USB<=>Serial converter. Some interferencies from con to usart was fixed.
2022-09-16 Update to implement new features and F4 support
    Doxygen in working progress. This firmware is an Emulator of MSX Keyboard subsystem, to make tests and performance measurements of the PS/2 to MSX Adatpter. Now implemented the Core M4 suppport and USB console and UART <=> USB.
    If USB is enumerated, console is attached to USB device, and the freeed USART has prized with a USB<=>Serial converter functionality. Some interferencies from con to usart were fixed.
2022-09-21 Update to implement new features and F4 support
    Doxygen documentation placed at html folder. Emulator of MSX Keyboard subsystem, to make tests and performance measurements of the PS/2 to MSX Adatpter. Now implemented the Core M4 suppport.
    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
2022-09-21 Fix typing errors
    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
2022-09-21 Documentation updated
    Update source files to correctly permit doxygen generate the html documentation.
    [cdcacm.h, hr_timer.c, hr_timer.h]
2022-09-22 Documentation updated
    Update source files to correctly allow doxygen generate the html documentation.
    [cdcacm.h, hr_timer.c, hr_timer.h]
2022-09-22 Documentation updated
    Kicad schematics
    [Tester-PS2-MSX-F4.sch]
2022-09-23 Tester-ps2-msxF1 PDF schematic
2022-09-23 Schematics of tester-ps2-msxF4
    [Tester-PS2-MSX-F4.sch]
2022-09-23 Tester for PS/2 to MSX Adapter is fully functional
    Add the Technical Manual. It describes a how-to tests. It is a on going (not finished) material.
2022-09-29 Rev 1.2
    Timing pins generation description has been updated, in carry of USB and F4 common design
    [MSX_tester.sch]
2022-09-29 Add timing port function
    Update F4 and F1 documentation
    [Tester-PS2-MSX-F4.sch]
2022-10-01 Update Kicad files
    Update F4 and F1 Kicad documentation
    [Tester-PS2-MSX-F4.sch]
2022-10-02 Add files via upload
    Bugs correction.
    [sys_timer.cpp, system.h, tester-ps2-msx.cpp]
2022-10-04 Add files via upload
    Bug correction and its respective documentation.
    [system.h, tester-ps2-msx.cpp]
2022-10-10 Schematics and Bug correction
    Due to a defective last Blue Pill, the schematics had to be updated, and I detected a bug in reading the converter
    [sys_timer.cpp, sys_timer.h, system.h]
2022-10-10 Schematics correction
    Due to a defective last Blue Pill, the schematics had to be updated.
2022-10-10 Binaries updated
    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
2022-12-03 Warning fixes due to v.12.2.0
    Fix warnings displayed due to (Arm GNU Toolchain 12.2.MPACBTI-Bet1 (Build arm-12-mpacbti.16)) 12.2.0 toolchain update on NEWLIB reentrant cakks, although I do NOT make use of them.
2024-04-27 To fit to 13.2.rel1-aarch64 GNU toolkit.
    Small bugs correction to allow successful compilation and correct system.h name inside Makefile to fit to arm-gnu-toolchain-13.2.rel1-aarch64-arm-none-eabi GNU toolkit.
    [system.h]
2024-09-21 Files compiled with Arm GNU Toolchain 13.3.Rel1
    Compiled with Arm GNU Toolchain 13.3.Rel1 Released: July 4
2024-09-21 File updated to Arm GNU Toolchain 13.3.Rel1
    README.md file updated to Arm GNU Toolchain 13.3.Rel1
2025-04-22 Files compiled with Arm GNU Toolchain 14.2.Rel1
    The created image files were compiled with the Arm GNU Toolchain 14.2.Rel1 Released: December 10, 2024
2025-04-22 Compile with Arm GNU Toolchain 14.2.Rel1
    Updated to compile with Arm GNU Toolchain 14.2.Rel1 Released: December 10, 2024
